meirmsn/cutlery-box/photos/finished-loaded.jpg

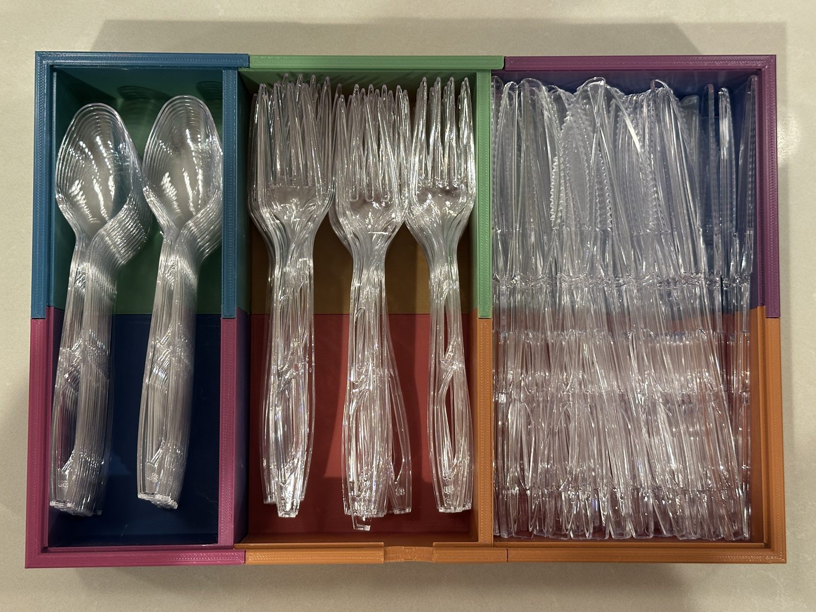
photos/finished-loaded.jpg
