meirmsn/cutlery-box/photos/process/IMG_8077.jpg

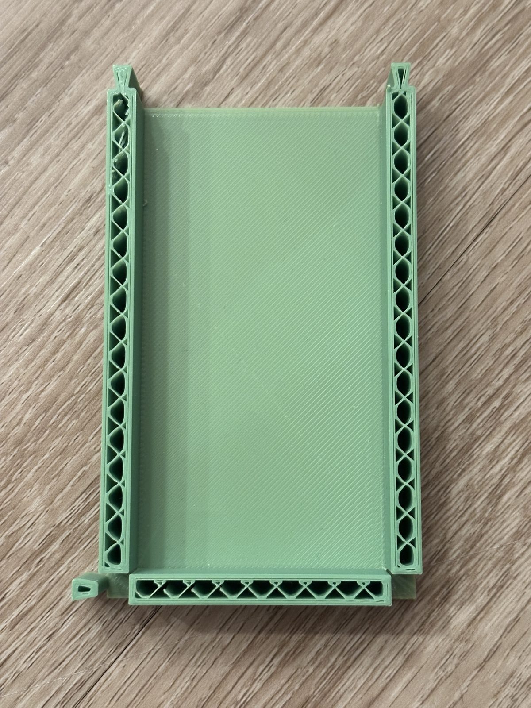
photos/process/IMG_8077.jpg
