meirmsn/cutlery-box/photos/process/IMG_8078.jpg

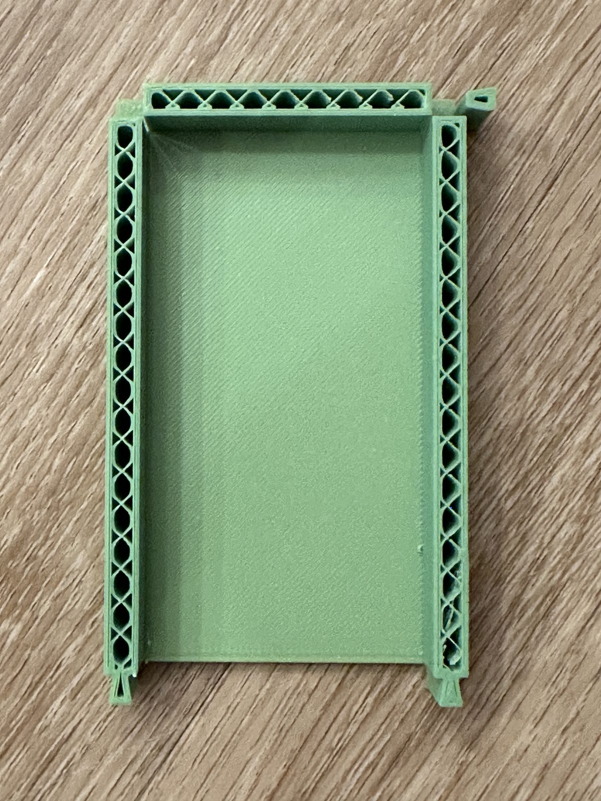
photos/process/IMG_8078.jpg
