meirmsn/cutlery-box/photos/process/IMG_8079.jpg

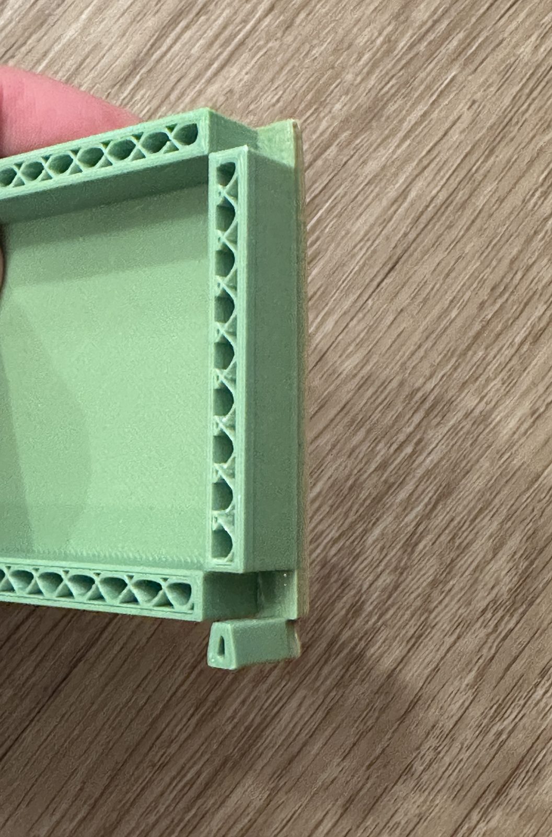
photos/process/IMG_8079.jpg
