meirmsn/cutlery-box/photos/process/IMG_8080.jpg

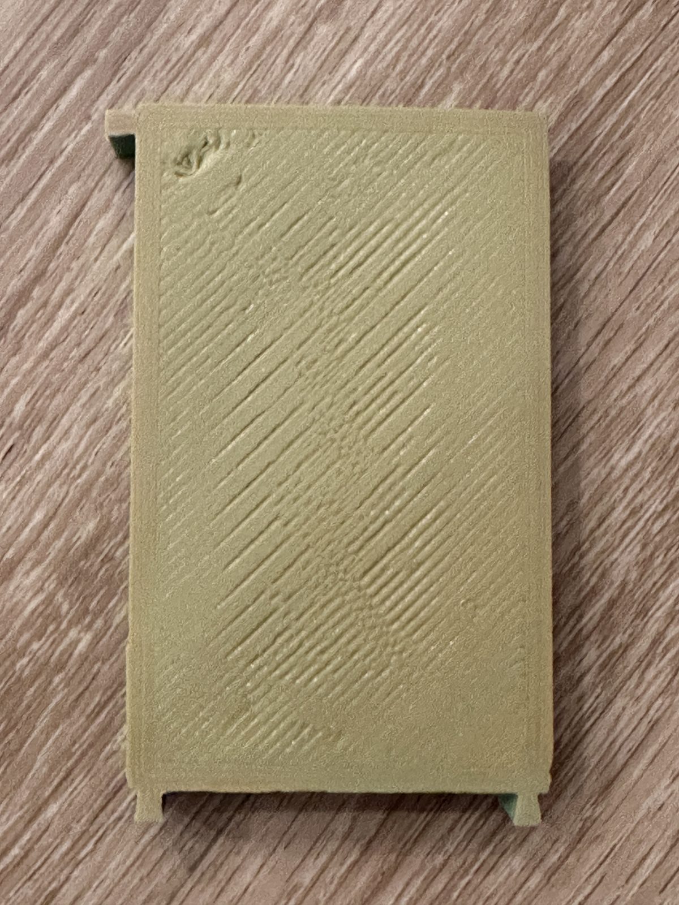
photos/process/IMG_8080.jpg
