meirmsn/cutlery-box/photos/process/IMG_8081.jpg

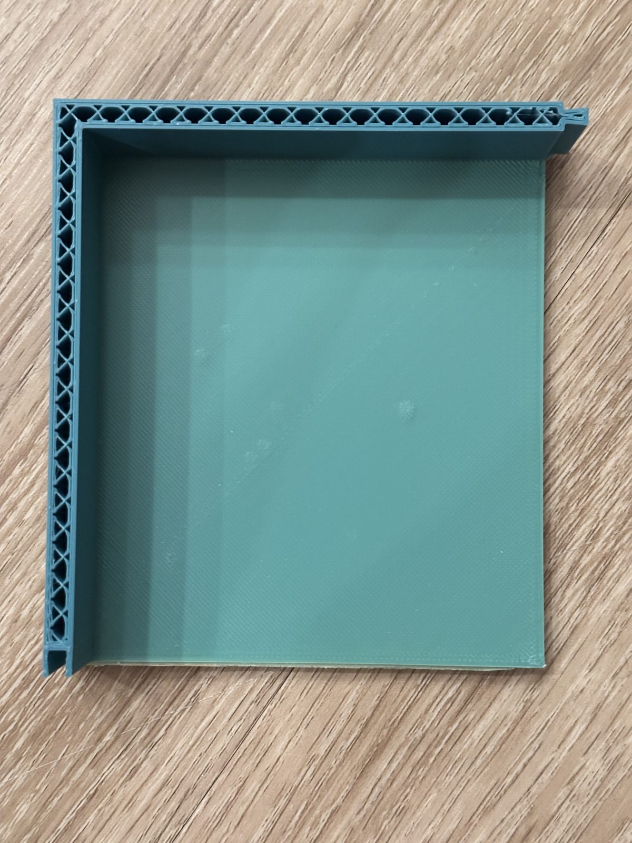
photos/process/IMG_8081.jpg
