meirmsn/cutlery-box/photos/process/IMG_8083.jpg

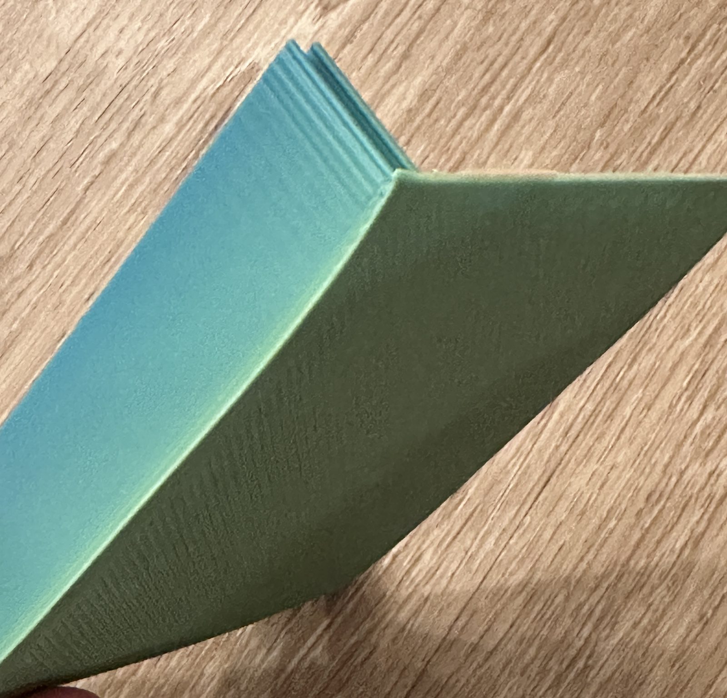
photos/process/IMG_8083.jpg
