meirmsn/cutlery-box/photos/process/IMG_8084.jpg

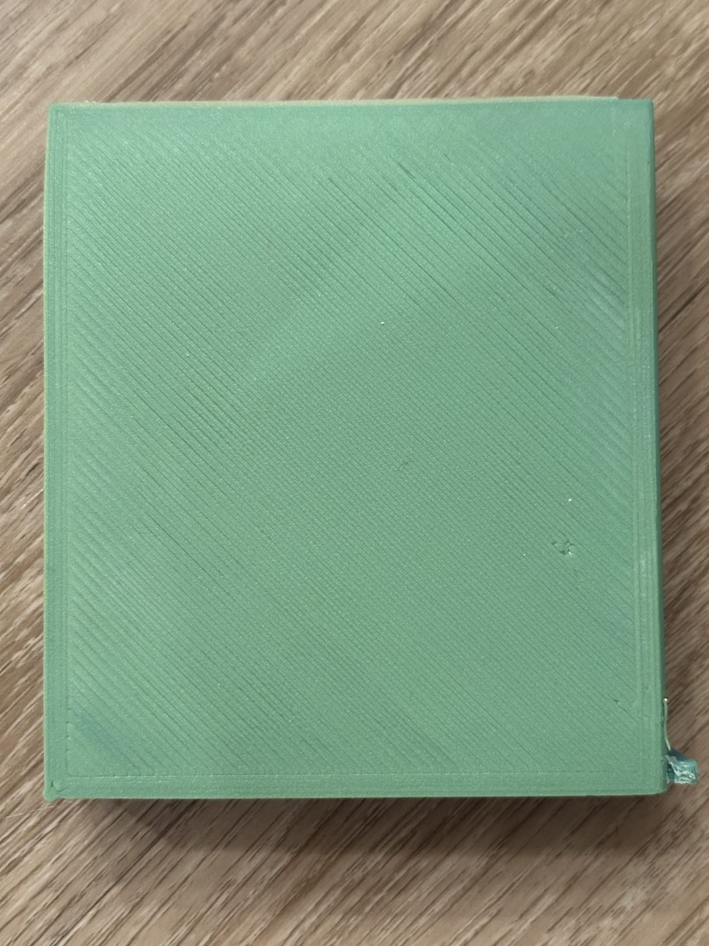
photos/process/IMG_8084.jpg
