meirmsn/cutlery-box/photos/process/IMG_8085.jpg

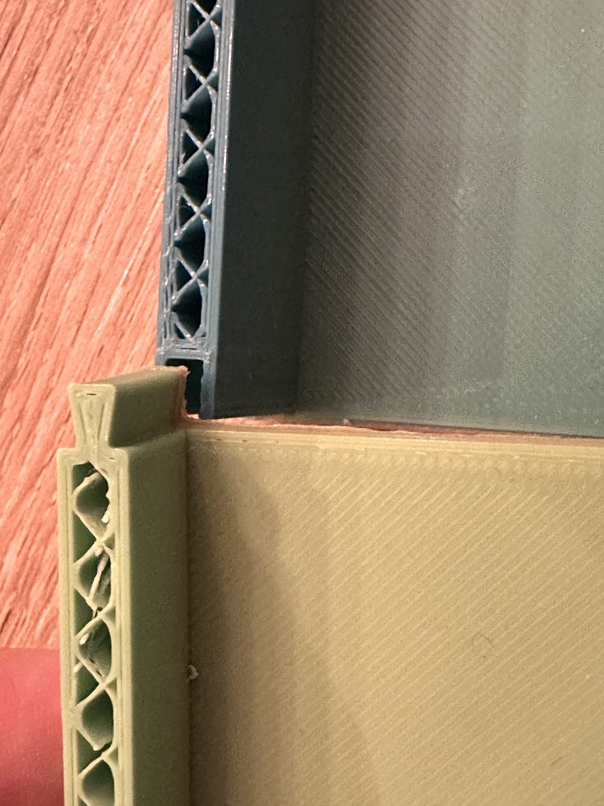
photos/process/IMG_8085.jpg
