meirmsn/cutlery-box/photos/process/IMG_8088.jpg

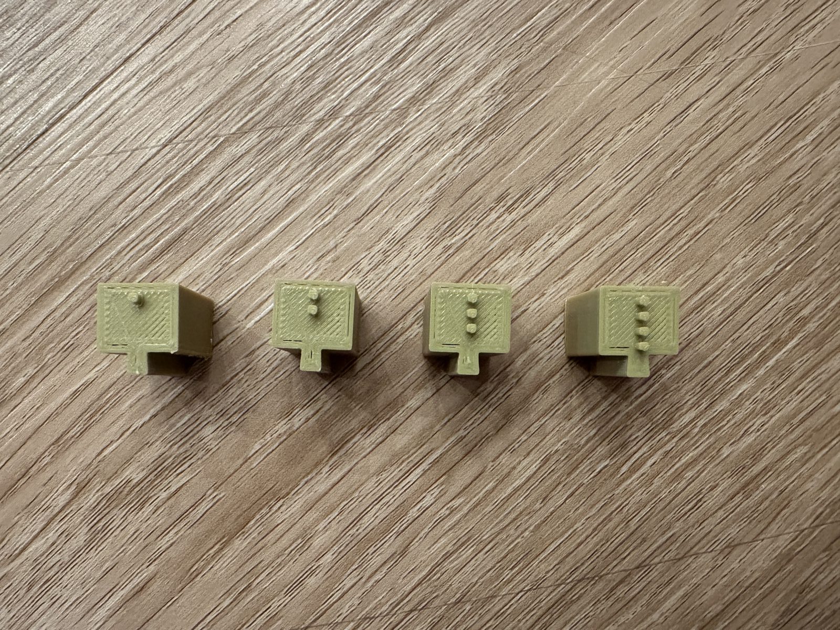
photos/process/IMG_8088.jpg
