meirmsn/cutlery-box/photos/process/IMG_8091.jpg

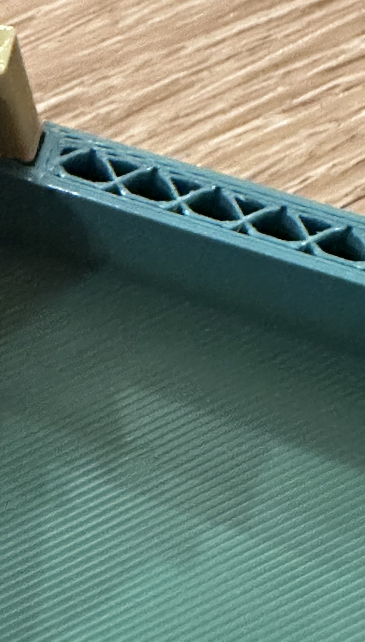
photos/process/IMG_8091.jpg
