meirmsn/cutlery-box/photos/process/IMG_8092.jpg

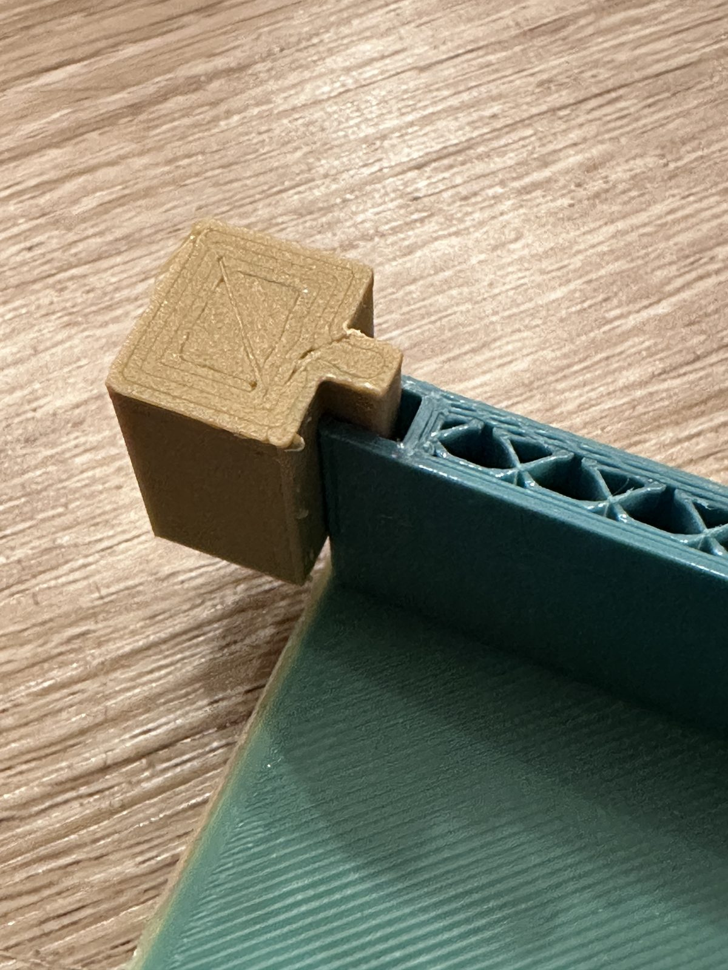
photos/process/IMG_8092.jpg
