meirmsn/cutlery-box/photos/process/IMG_8097.jpg

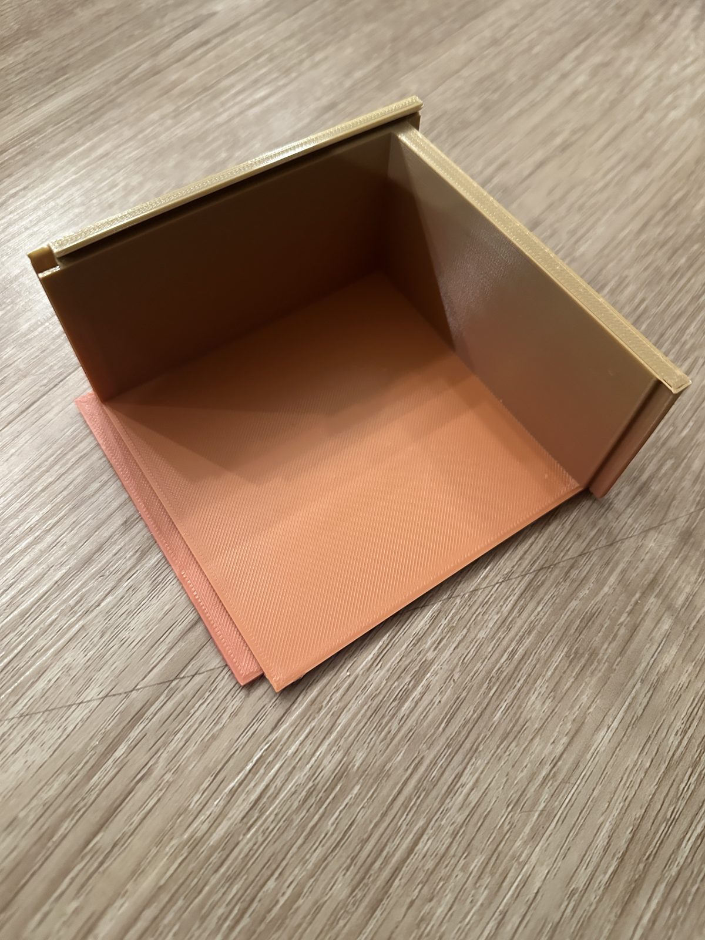
photos/process/IMG_8097.jpg
