meirmsn/cutlery-box/photos/process/IMG_8098.jpg

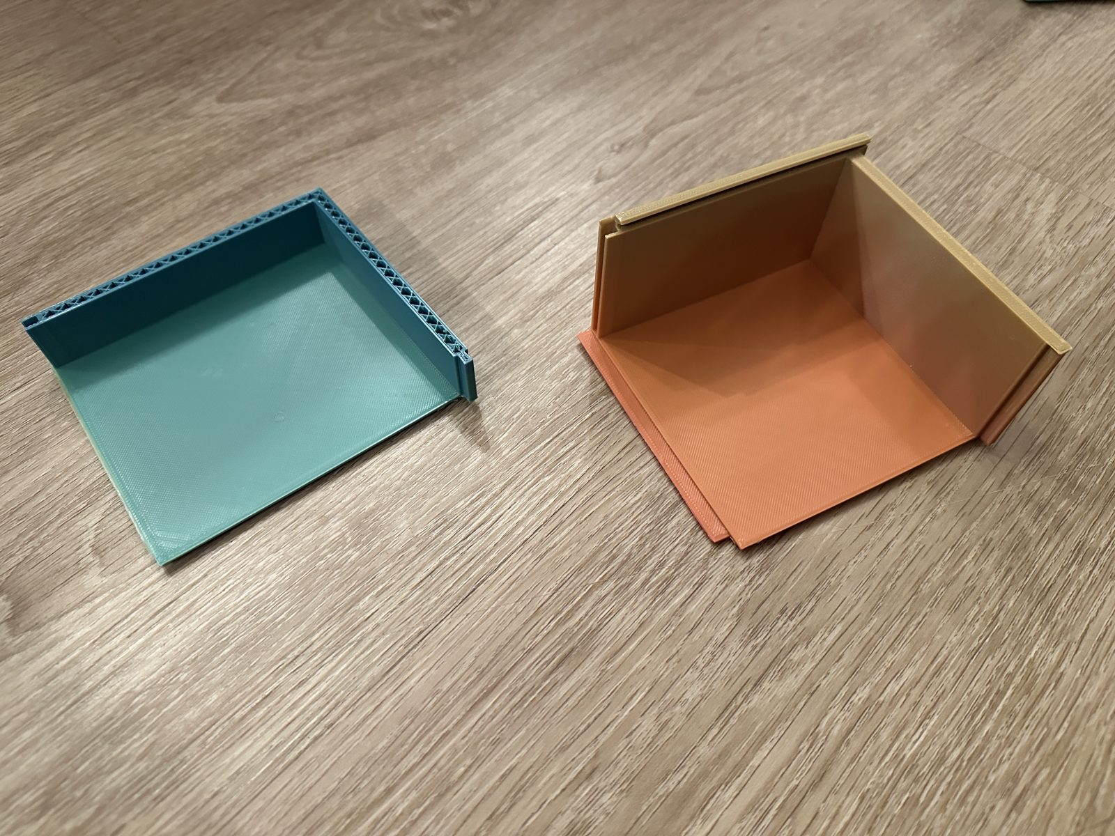
photos/process/IMG_8098.jpg
