meirmsn/cutlery-box/photos/process/IMG_8100.jpg

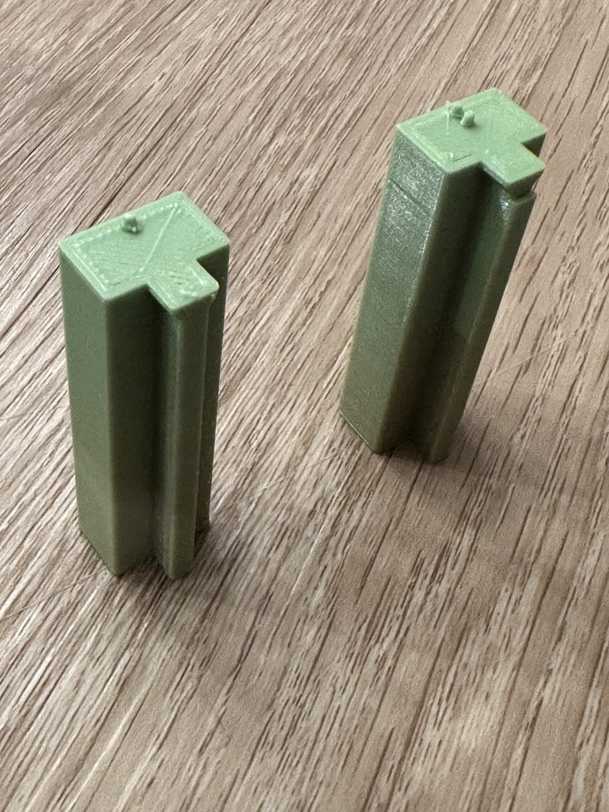
photos/process/IMG_8100.jpg
