meirmsn/cutlery-box/photos/process/IMG_8101.jpg

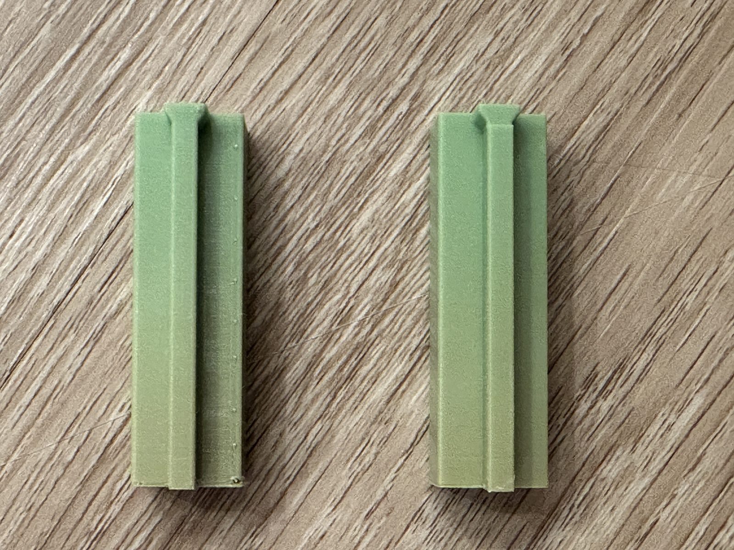
photos/process/IMG_8101.jpg
