meirmsn/cutlery-box/photos/process/IMG_8102.jpg

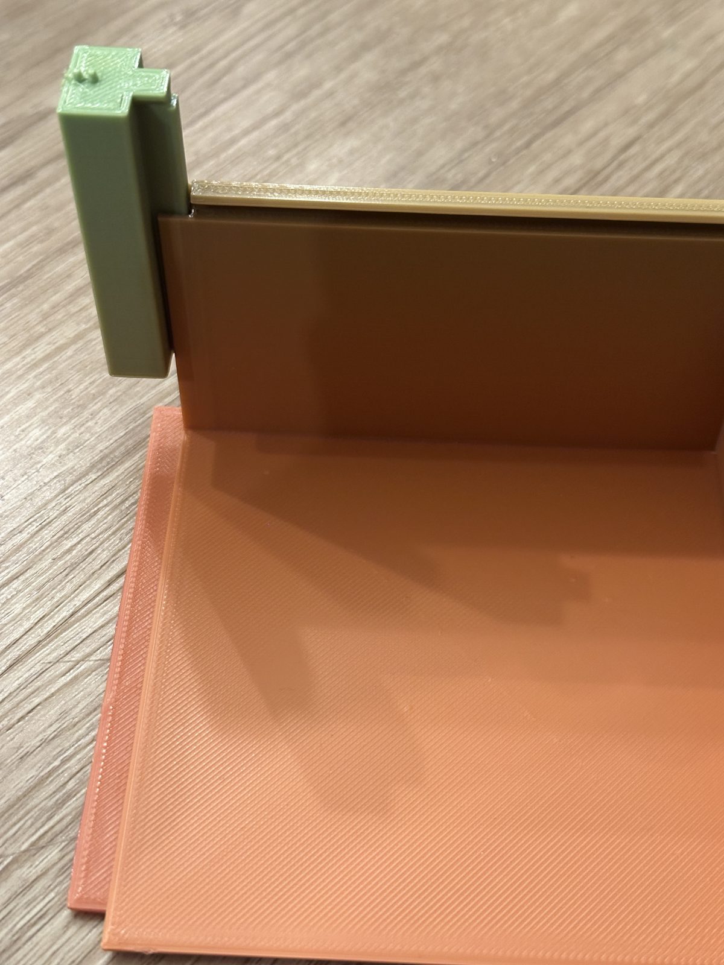
photos/process/IMG_8102.jpg
