meirmsn/cutlery-box/photos/process/IMG_8104.jpg

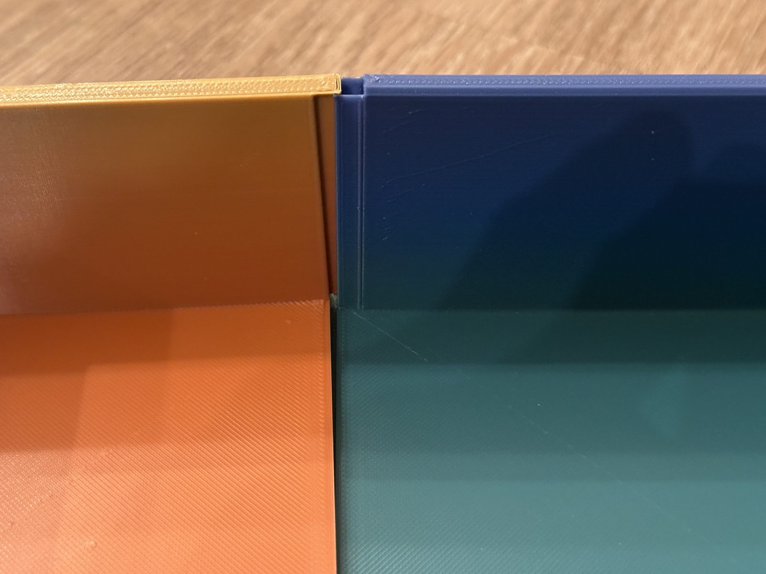
photos/process/IMG_8104.jpg
