meirmsn/cutlery-box/photos/process/IMG_8105.jpg

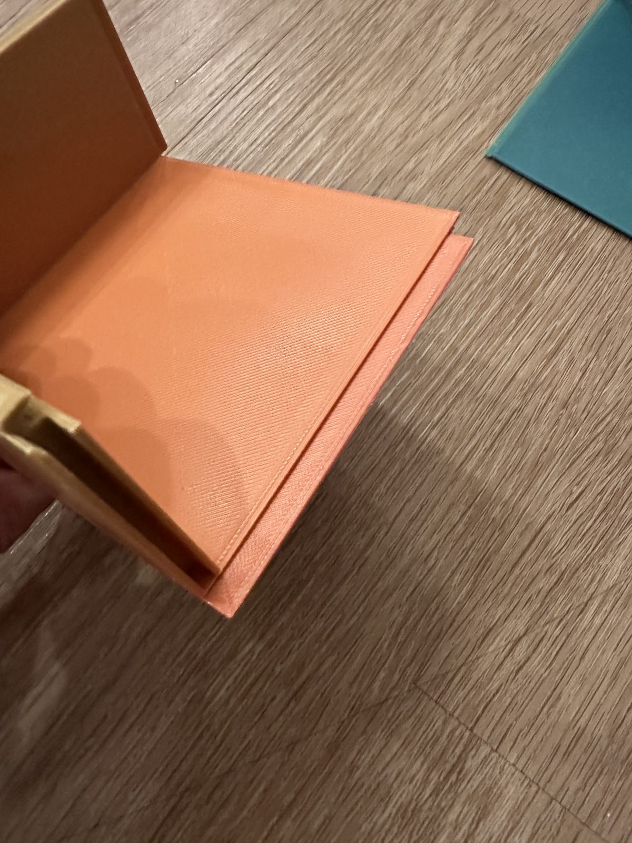
photos/process/IMG_8105.jpg
