meirmsn/cutlery-box/photos/process/IMG_8106.jpg

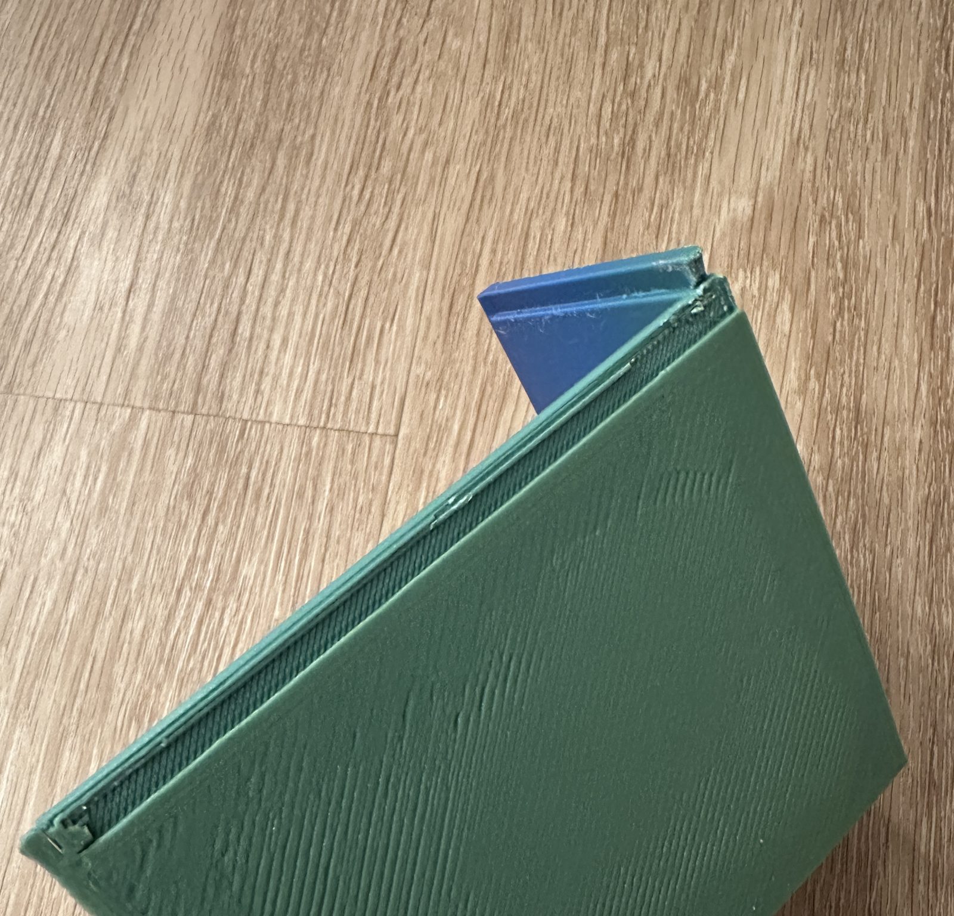
photos/process/IMG_8106.jpg
