meirmsn/cutlery-box/photos/process/IMG_8107.jpg

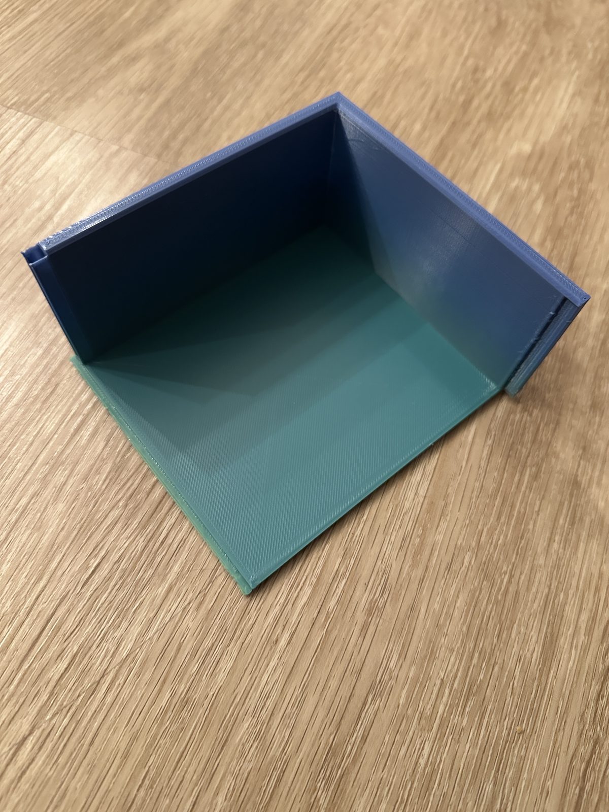
photos/process/IMG_8107.jpg
