meirmsn/cutlery-box/photos/process/IMG_8108.jpg

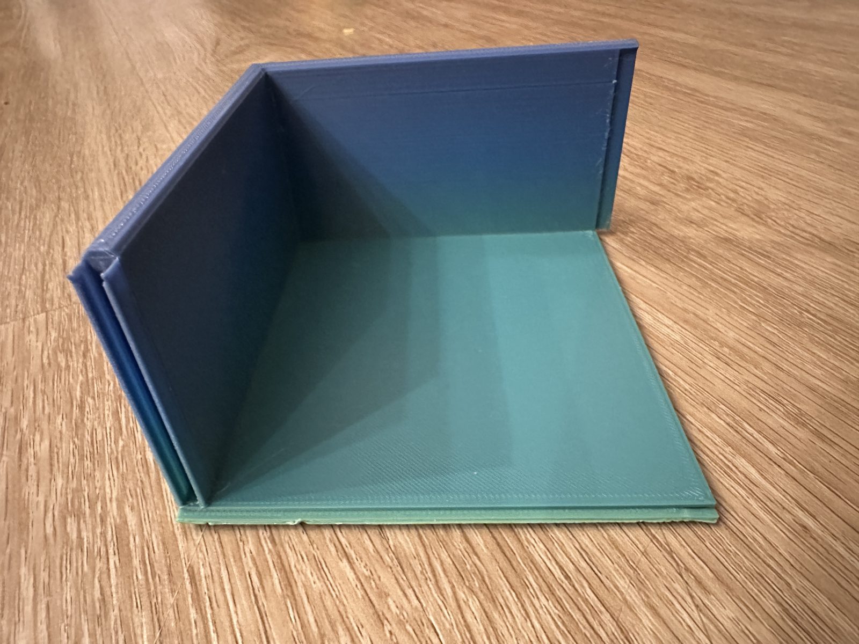
photos/process/IMG_8108.jpg
