meirmsn/cutlery-box/photos/process/IMG_8109.jpg

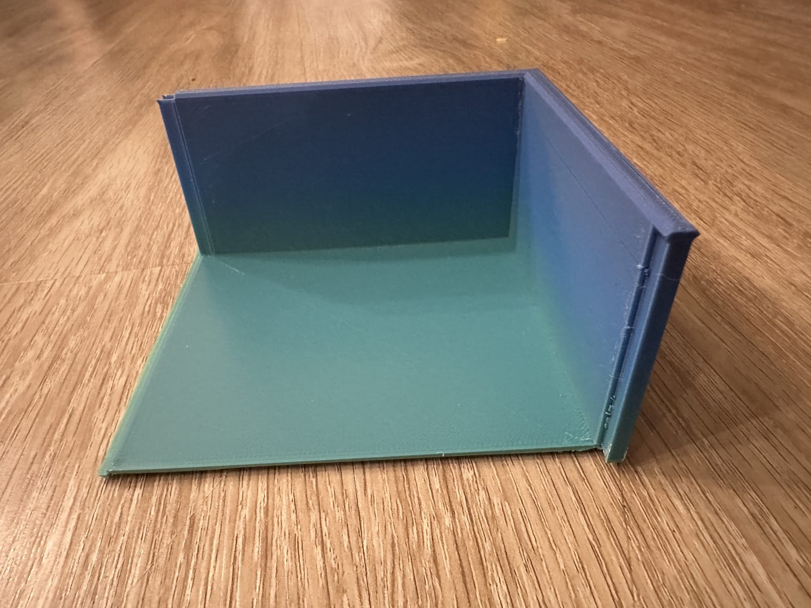
photos/process/IMG_8109.jpg
