meirmsn/cutlery-box/photos/process/IMG_8110.jpg

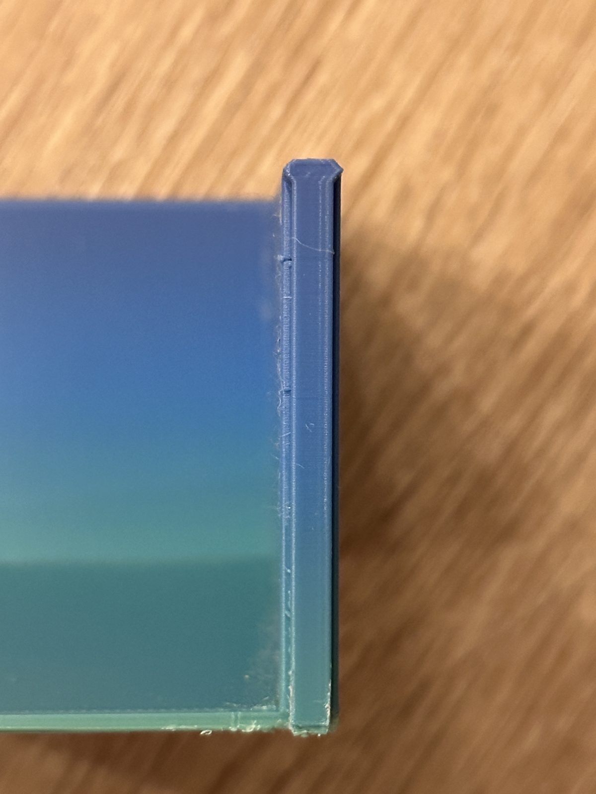
photos/process/IMG_8110.jpg
