meirmsn/cutlery-box/photos/process/IMG_8111.jpg

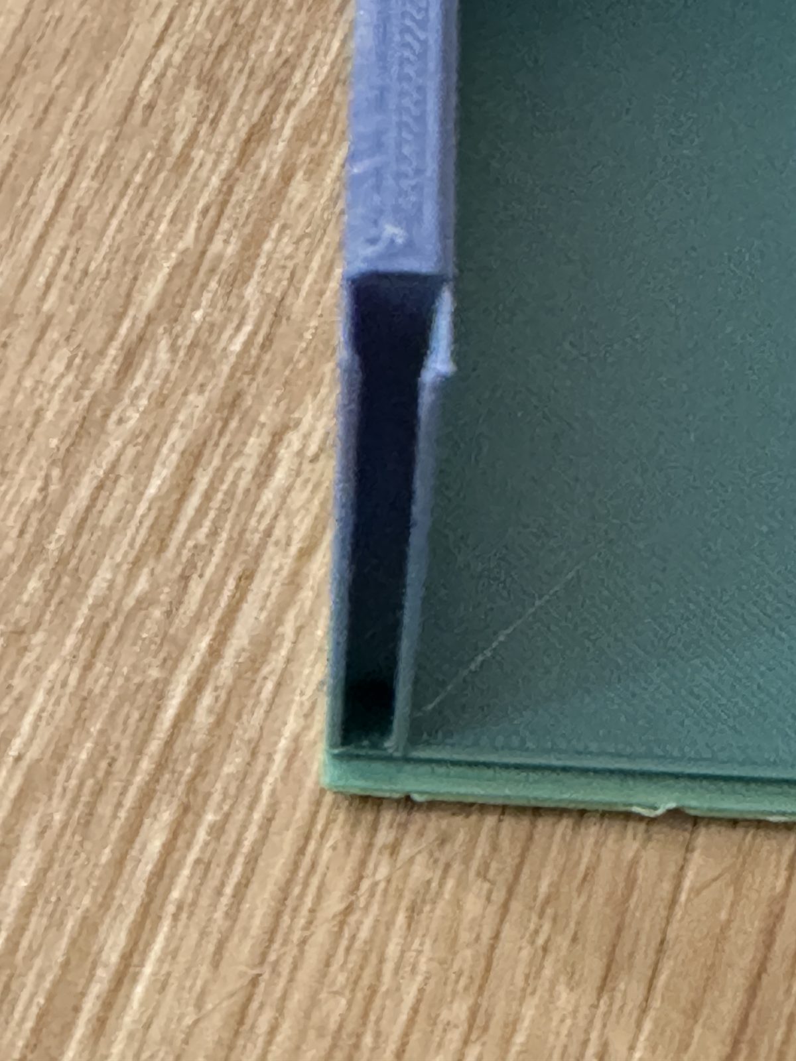
photos/process/IMG_8111.jpg
