meirmsn/cutlery-box/photos/process/IMG_8112.jpg

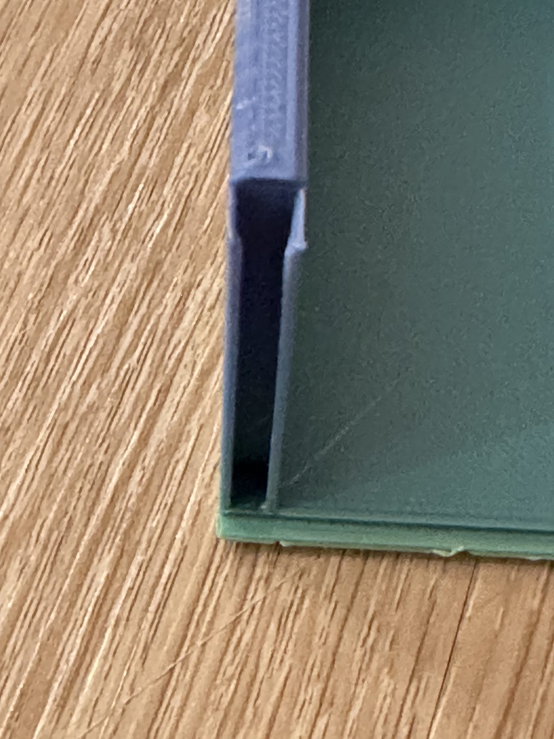
photos/process/IMG_8112.jpg
