meirmsn/cutlery-box/photos/process/IMG_8113.jpg

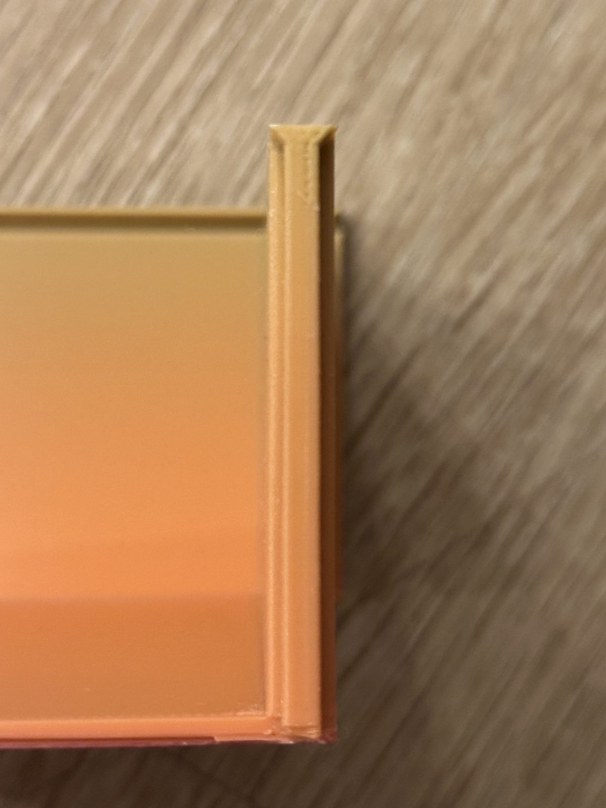
photos/process/IMG_8113.jpg
