meirmsn/cutlery-box/photos/process/IMG_8114.jpg

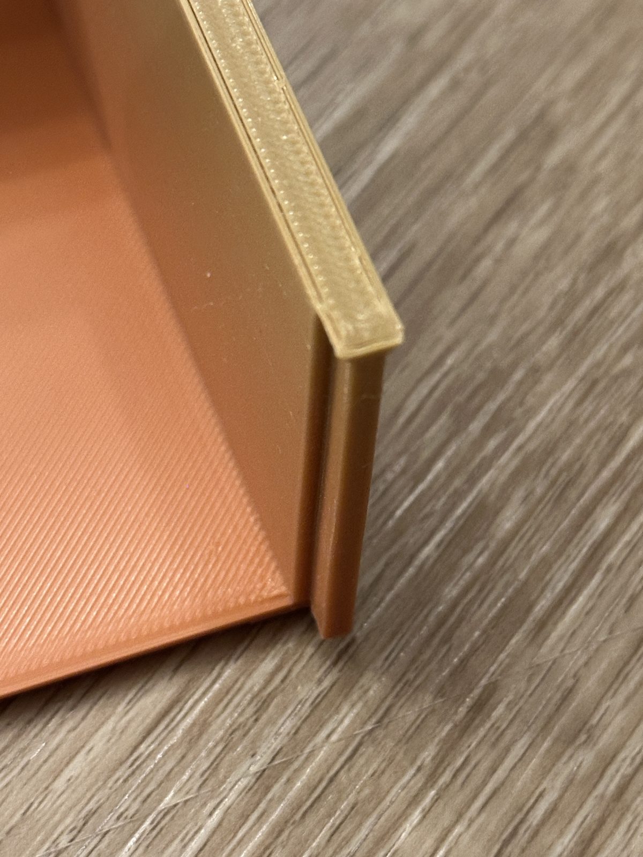
photos/process/IMG_8114.jpg
