meirmsn/cutlery-box/photos/process/IMG_8115.jpg

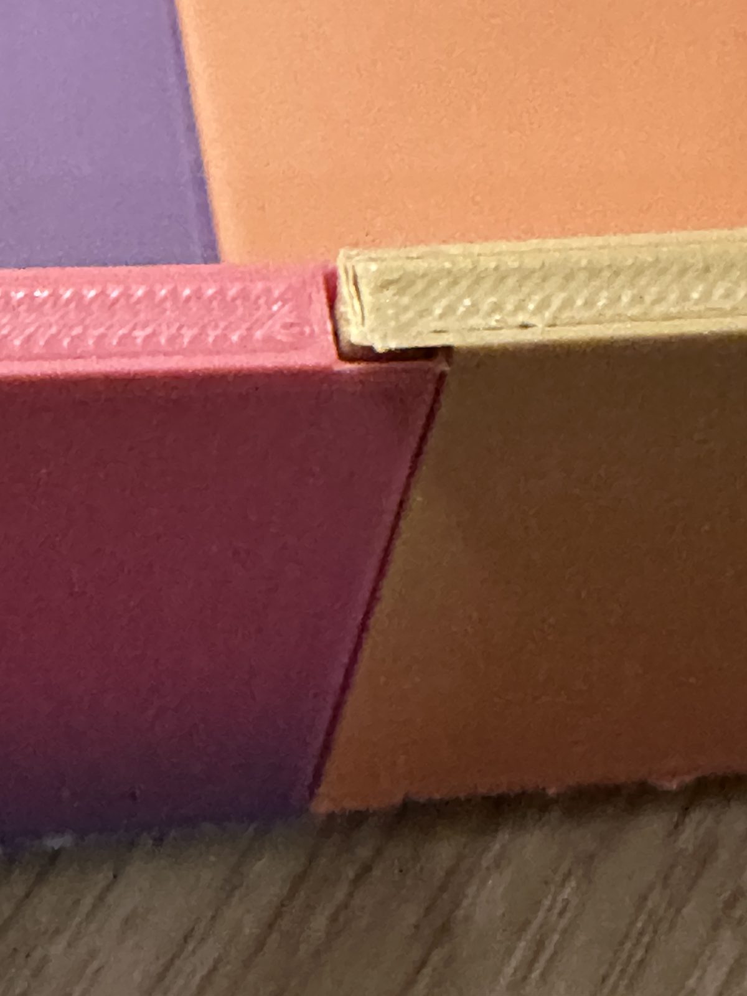
photos/process/IMG_8115.jpg
