meirmsn/cutlery-box/photos/process/IMG_8116.jpg

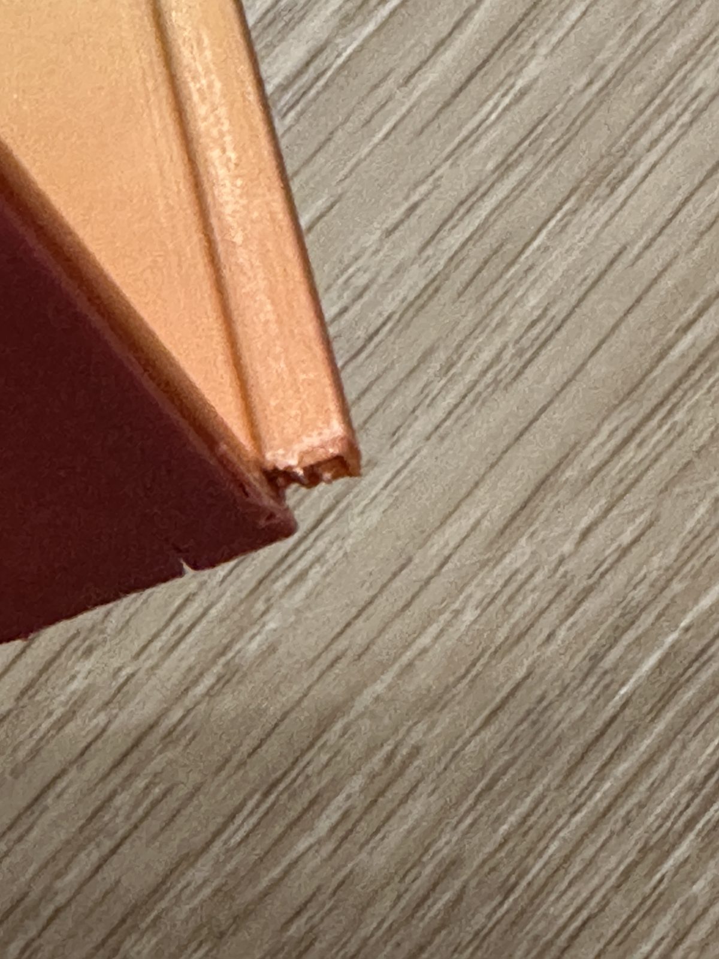
photos/process/IMG_8116.jpg
