meirmsn/cutlery-box/photos/process/IMG_8118.jpg

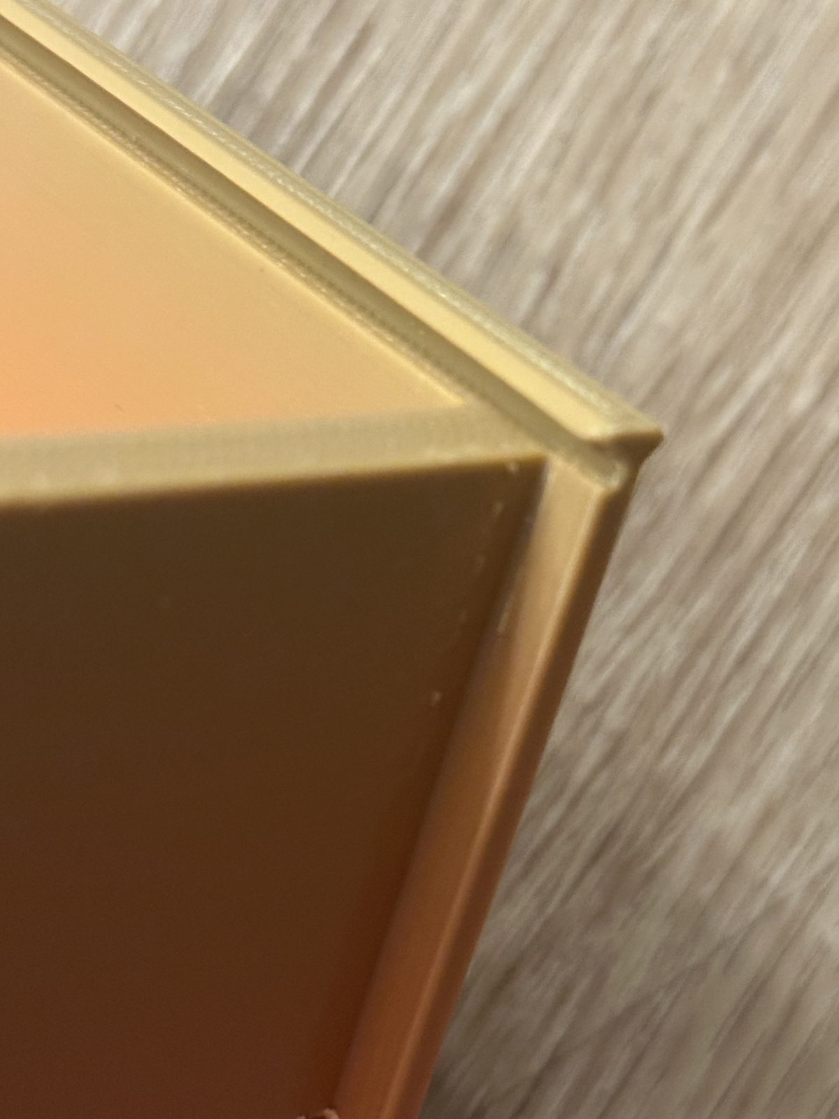
photos/process/IMG_8118.jpg
