meirmsn/cutlery-box/photos/process/IMG_8120.jpg

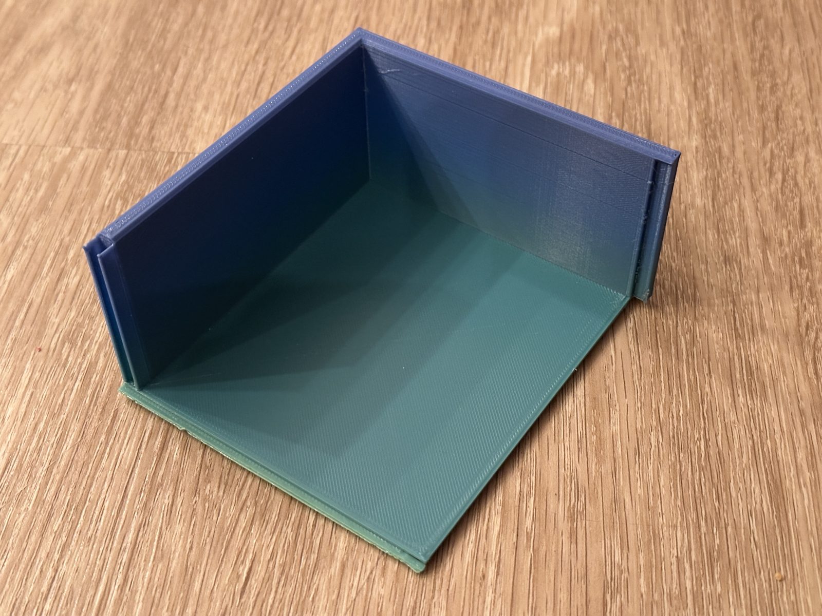
photos/process/IMG_8120.jpg
