meirmsn/cutlery-box/photos/process/IMG_8121.jpg

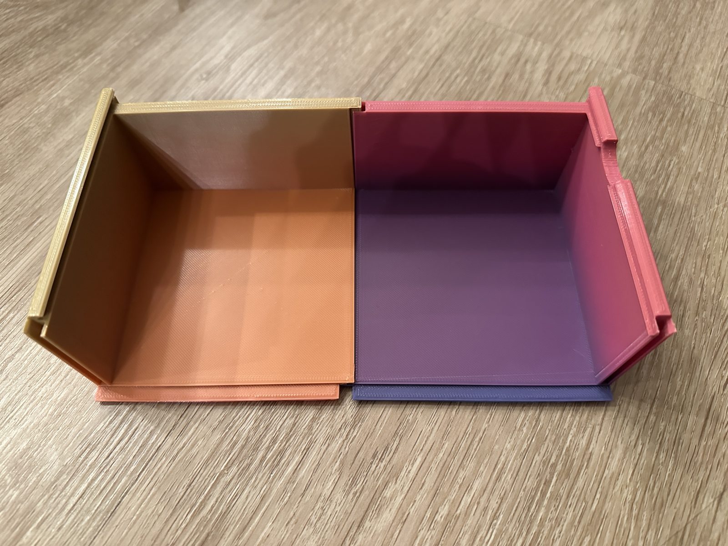
photos/process/IMG_8121.jpg
