meirmsn/cutlery-box/stl/body_fork_A.stl

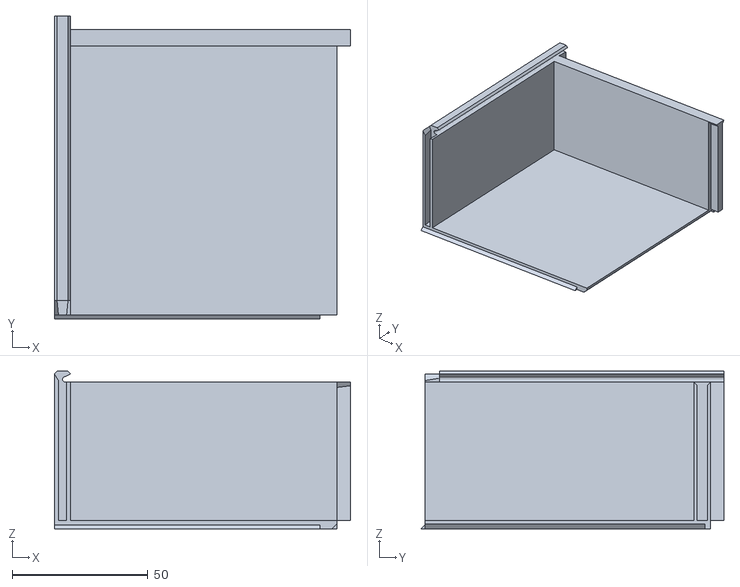
[picture p39: CAD file, 2026-11-13]
stl/body_fork_A.stl
109.0 x 111.5 x 58.0
