meirmsn/cutlery-box/stl/test-coupons/dovetail_male_test.stl

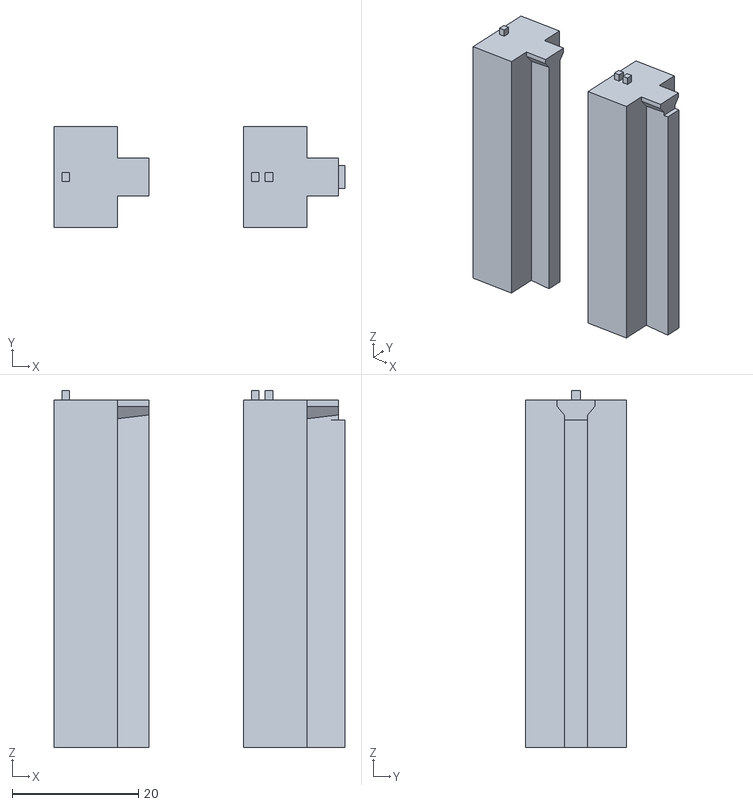
[picture p40: CAD file, 2026-11-13]
stl/test-coupons/dovetail_male_test.stl
46.0 x 16.0 x 56.5
