meirmsn/cutlery-box/stl/test-coupons/dovetail_fit_test_rig.stl

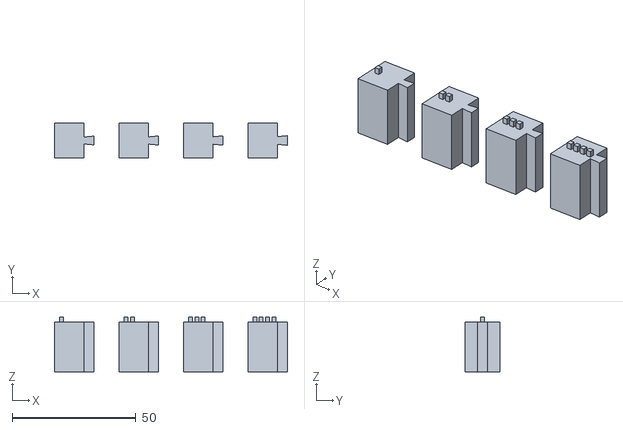
[picture p41: CAD file, 2026-11-13]
stl/test-coupons/dovetail_fit_test_rig.stl
94.0 x 14.0 x 22.0
