meirmsn/cutlery-box/stl/body_knife_B.stl

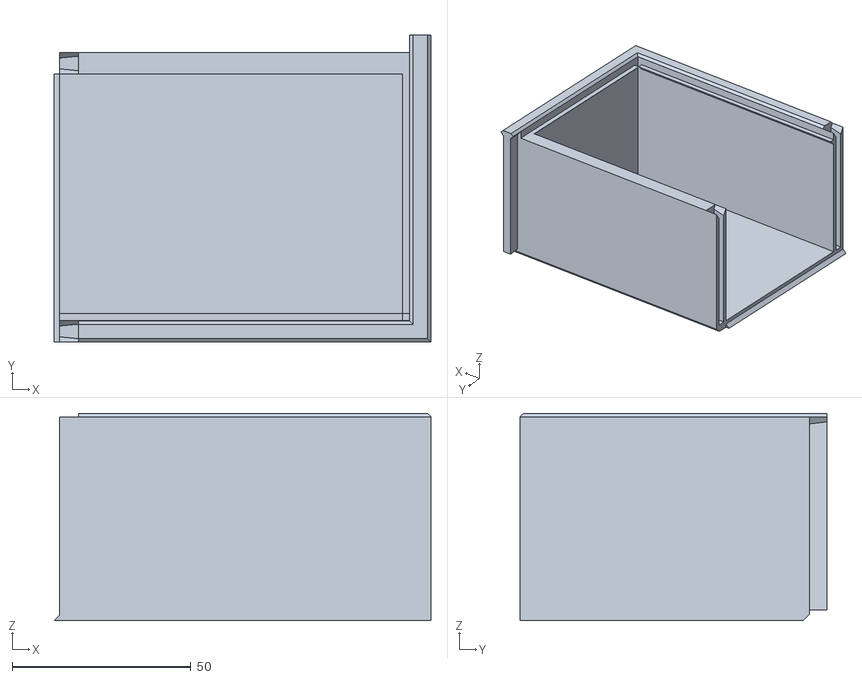
[picture p42: CAD file, 2026-11-13]
stl/body_knife_B.stl
105.5 x 86.0 x 58.0
