meirmsn/cutlery-box/stl/body_spoon_A.stl

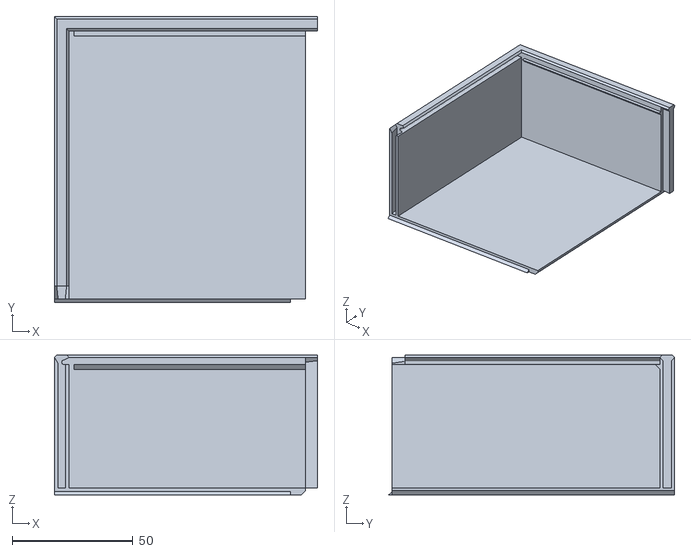
[picture p43: CAD file, 2026-11-13]
stl/body_spoon_A.stl
109.0 x 118.5 x 58.0
