meirmsn/cutlery-box/archive/versions/cutlery_box_v4/body_spoon_A.stl

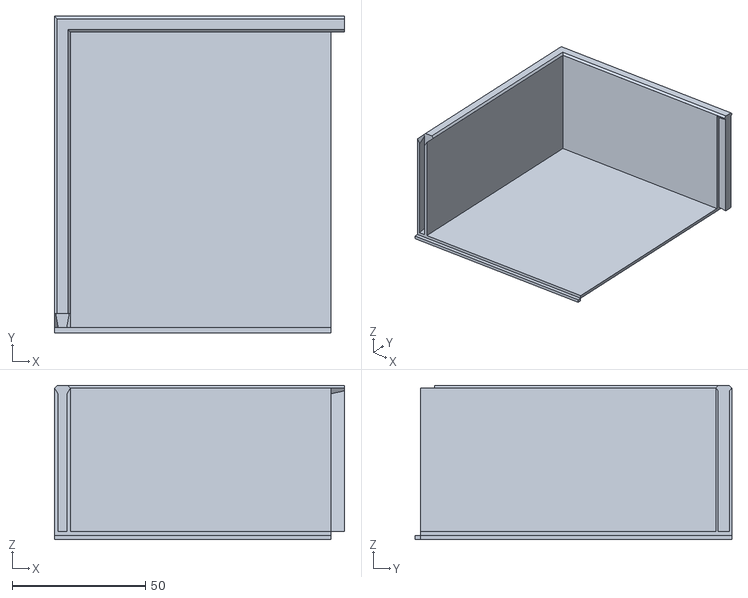
[picture p44: CAD file, 2026-11-13, an earlier design]
archive/versions/cutlery_box_v4/body_spoon_A.stl
109.0 x 119.0 x 58.0
