meirmsn/cutlery-box/archive/versions/cutlery_box_v24/body_spoon_B.stl

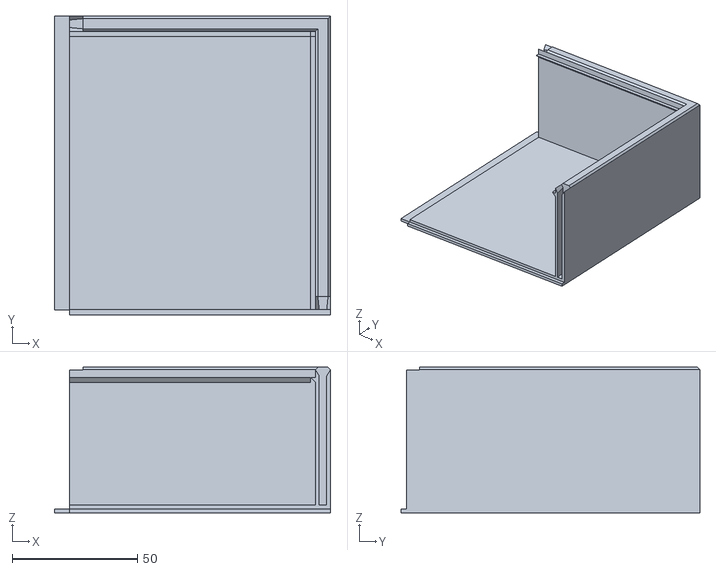
[picture p45: CAD file, 2026-11-13, an earlier design]
archive/versions/cutlery_box_v24/body_spoon_B.stl
110.0 x 119.0 x 58.0
