meirmsn/cutlery-box/archive/versions/cutlery_box_v4/body_fork_B.stl

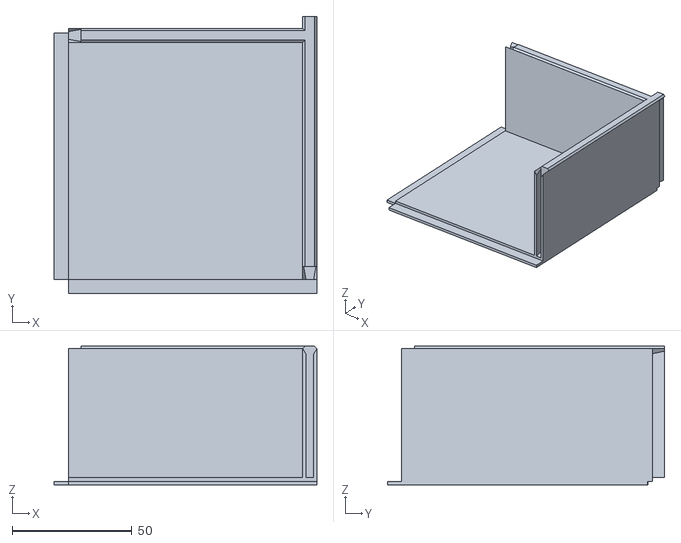
[picture p46: CAD file, 2026-11-13, an earlier design]
archive/versions/cutlery_box_v4/body_fork_B.stl
110.0 x 116.0 x 58.0
