meirmsn/cutlery-box/archive/versions/cutlery_box_v4/body_knife_A.stl

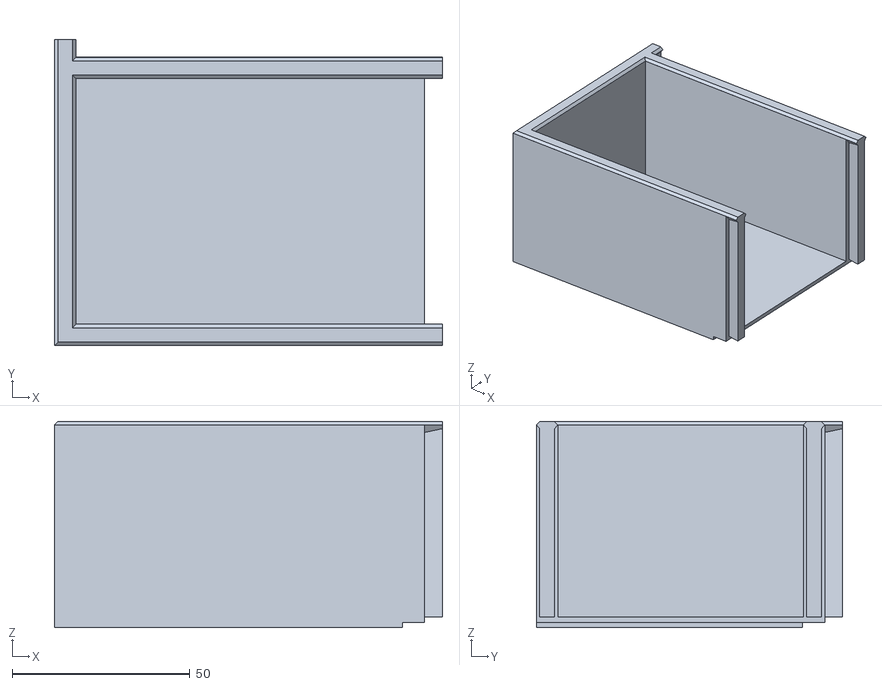
[picture p47: CAD file, 2026-11-13, an earlier design]
archive/versions/cutlery_box_v4/body_knife_A.stl
109.0 x 86.0 x 58.0
