meirmsn/cutlery-box/(list of files, cad)

Other CAD files:
stl/body_fork_B.stl
stl/body_spoon_B.stl
stl/body_knife_A.stl
archive/versions/cutlery_box_v24/body_spoon_A.stl
archive/versions/cutlery_box_v24/body_fork_B.stl
archive/versions/cutlery_box_v24/body_knife_A.stl
archive/versions/cutlery_box_v1.scad
archive/versions/cutlery_box_v10_lid.scad
archive/versions/cutlery_box_v11_lid.scad
archive/versions/cutlery_box_v12_lid.scad
archive/versions/cutlery_box_v13_lid.scad
archive/versions/cutlery_box_v14_lid.scad
archive/versions/cutlery_box_v15_lid.scad
archive/versions/cutlery_box_v16_lid.scad
archive/versions/cutlery_box_v17_lid.scad
archive/versions/cutlery_box_v18_lid.scad
archive/versions/cutlery_box_v19_lid.scad
archive/versions/cutlery_box_v2.scad
archive/versions/cutlery_box_v20_lid.scad
archive/versions/cutlery_box_v21_lid.scad
archive/versions/cutlery_box_v22_lid.scad
archive/versions/cutlery_box_v23_stable.scad
archive/versions/cutlery_box_v24/body_fork_A.stl
archive/versions/cutlery_box_v24/body_knife_B.stl
archive/versions/cutlery_box_v24/cutlery_box_v24_stable.scad
archive/versions/cutlery_box_v25/body_fork_B.stl
archive/versions/cutlery_box_v25/body_knife_A.stl
archive/versions/cutlery_box_v25/body_spoon_B.stl
archive/versions/cutlery_box_v3.scad
archive/versions/cutlery_box_v4/body_fork_A.stl
archive/versions/cutlery_box_v4/body_knife_B.stl
archive/versions/cutlery_box_v4/body_spoon_B.stl
archive/versions/cutlery_box_v4/cutlery_box_v4.scad
archive/versions/cutlery_box_v5_lid.scad
archive/versions/cutlery_box_v6_lid.scad
archive/versions/cutlery_box_v7_lid.scad
archive/versions/cutlery_box_v8_lid.scad
archive/versions/cutlery_box_v9_lid.scad
