meirmsn/cutlery-box/(commit log)

2026-11-13 Package the cutlery box: source, STLs, photos, build log, archive
    The final OpenSCAD model (v25) and its six exported pieces, the joint
    test coupons and their generators, photos of the finished box and the
    test prints (location data removed), a README and a step-by-step build
    log, and every earlier version, note and screenshot from the design
    process under archive/ so the repo is the single source of truth.
    [body_fork_A.stl, body_fork_B.stl, body_knife_A.stl, body_knife_B.stl, body_spoon_A.stl, body_spoon_B.stl, cutlery_box.scad, cutlery_box_v1.scad]
2026-11-13 Add close-up renders of each design change and expand the build log
    Grey renders of the four saved versions at the spots that changed:
    the rim seam (dovetail outline, then a cap), the hinge wall, the base
    joint (flat shelf, then a 45° wedge) and the finger notch with its
    clips, plus a diagram of why overlapping walls printed hollow. The
    build log now opens with why the box was needed and describes the lid
    features as designed but untested.
2026-11-13 Record the photo privacy rule: no sharp fingertips
2026-11-13 Add capacity, printer details, lid render strips and a colour social preview
    - Build log: designed vs final layout with counts (120 -> 184, +53%),
    why the final split, and other layouts to try; printer model, photo
    and print settings; IMG_8117 recaptioned as print marks; hinge-groove
    (v4-v10) and notch (v19-v22) strips from the owner's OpenSCAD renders,
    converted to grey; v20 wording corrected.
    - README: final-layout photo, capacity, printer model.
    - tools: render_stl.py --colors, make_social_preview.py; new preview.
    - CLAUDE.md: new facts, open items updated.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
2026-11-13 Apply review fixes to captions, claims and tools
    - Captions: hinge-wall caption covers all four panels; v5 and v19
    described as the scad files show them.
    - Claims: 184 credited to packing on edge, "our usual" cutlery, no
    inferred conditions or added adjectives.
    - .gitignore: only the top-level renders/ is ignored.
    - make_social_preview.py: font fallback, docstring matches the commands
    used; preview recropped.
    Claude-Session: https://claude.ai/code/session_012aPeyjSX6YEt2x8DFvdxWD
2026-11-13 Add the designed-layout and first-print photos and the stacking lesson
    - Capacity comparison now shows the designed layout (face-up columns).
    - First test prints: the knife slice that fit only two knives.
    - Living with it: stacks fell even standing still; three-across was
    checked on every part but stacking only at the end; trade-offs of
    packing on edge (looks, hygiene).
    - README wording matches; CLAUDE.md facts and open items updated.
    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
2026-11-14 Shrink portrait photos and use the composition as the README hero
    - Build log: standalone portrait photos centred at 360 px wide (the
    printer at 240) instead of full width.
    - Social preview now shows the six pieces pulled apart in colour beside
    the box in use, and is also the README's first image.
    - CLAUDE.md: image-size rule; reminders to retake the final-layout
    photo and send the three-knives test photo.
    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
2026-11-14 Use the retaken final-layout photo; add print settings and v25
    - photos/final-layout.jpg retaken with the top rows pointing the same
    way; README hero / social preview rebuilt from it, subtitle now says
    "120 mm 3D printer".
    - Build log: v25 (as he thinks), default wall thickness and infill with
    his hedge, and that 48 knives were counted but the columns were a
    pain to fill.
    - CLAUDE.md: answered items removed; nozzle and row-direction questions
    added.
    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
